lucianovk/kinova-cam/out/images/ring_d405/01_robo_completo.png

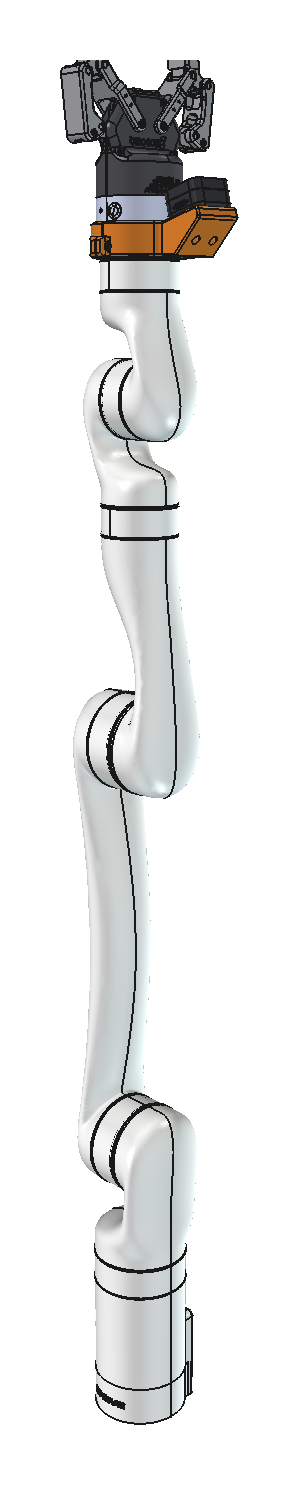
out/images/ring_d405/01_robo_completo.png
