lucianovk/kinova-cam/out/images/ring_d405/03_punho_parafusos.png

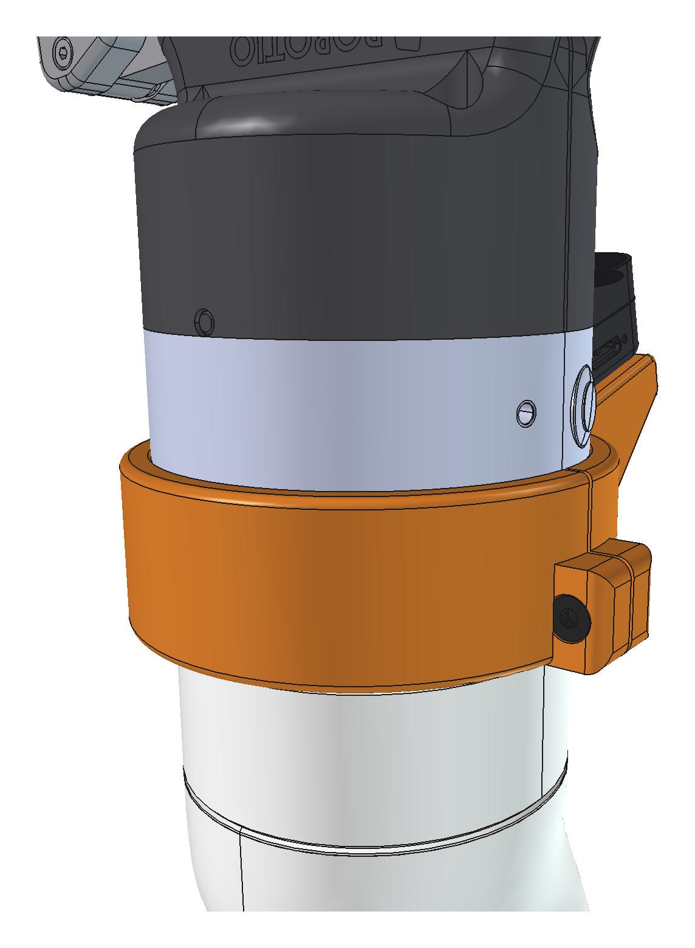
out/images/ring_d405/03_punho_parafusos.png
