lucianovk/kinova-cam/out/images/ring_d405/04_punho_lateral.png

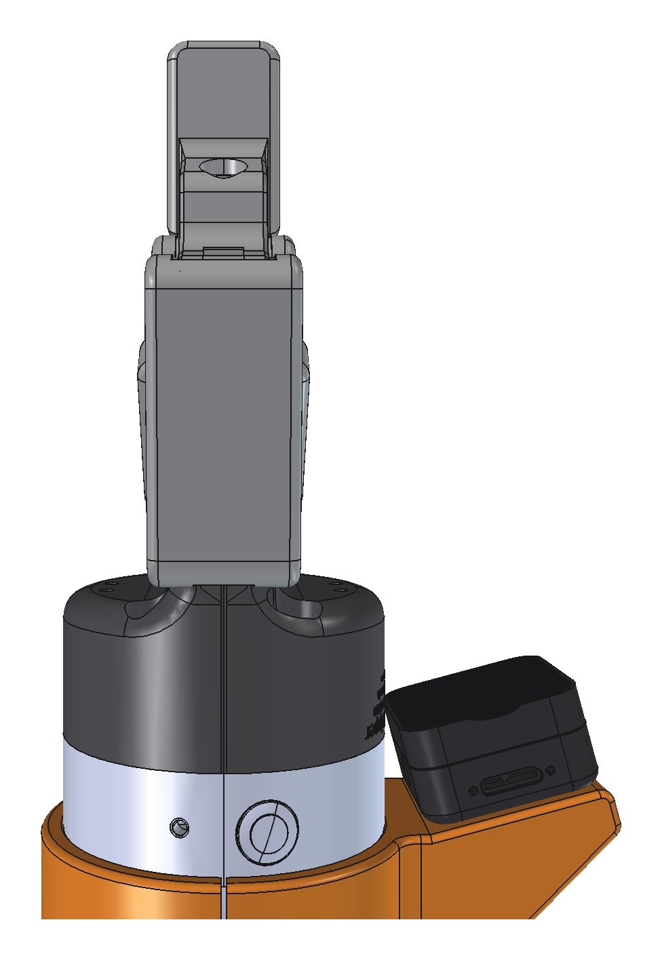
out/images/ring_d405/04_punho_lateral.png
