lucianovk/kinova-cam/out/images/ring_d405/07_explodida.png

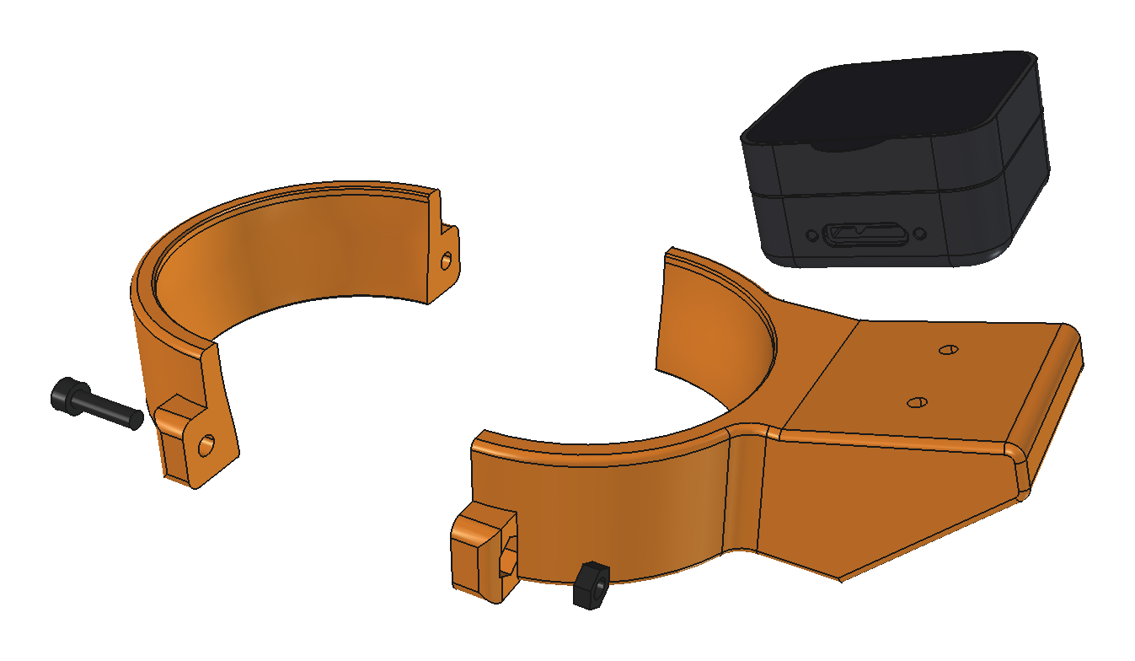
out/images/ring_d405/07_explodida.png
