lucianovk/kinova-cam/out/images/ring_d405/09_campo_de_visao.png

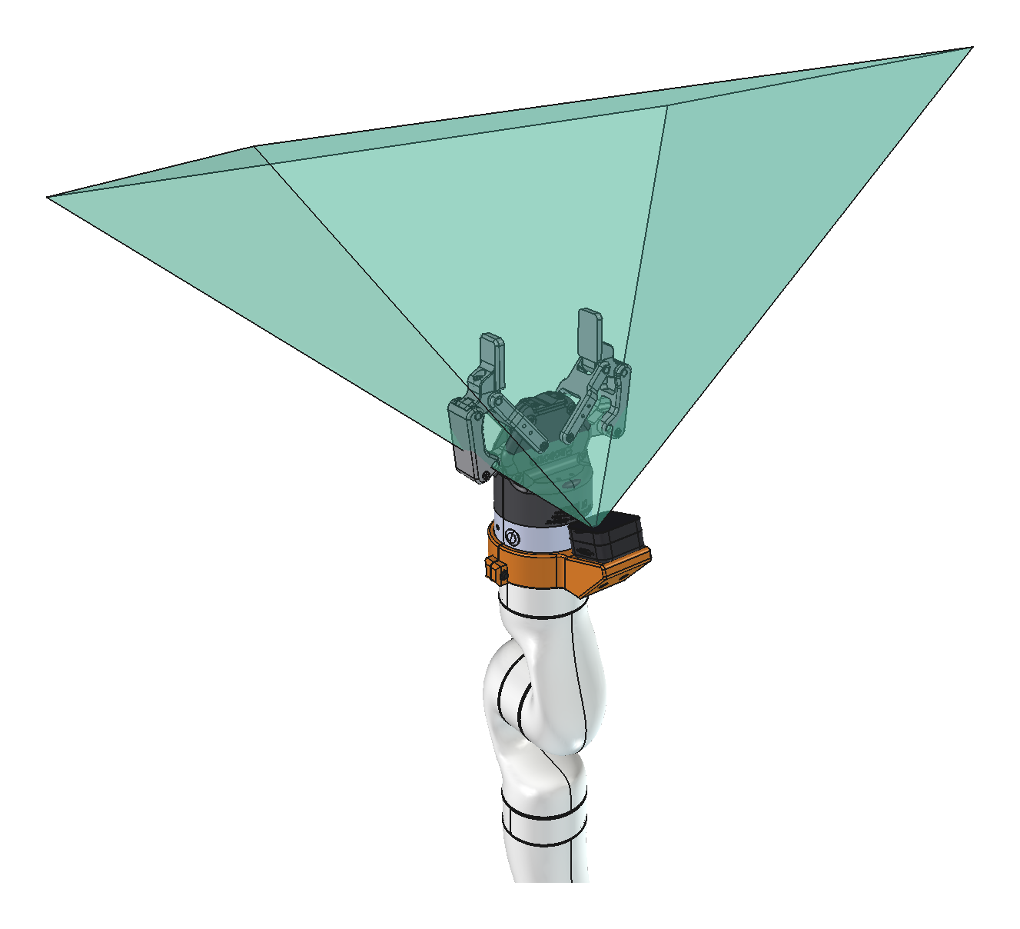
out/images/ring_d405/09_campo_de_visao.png
