lucianovk/kinova-cam/out/images/ring_rgb/01_robo_completo.png

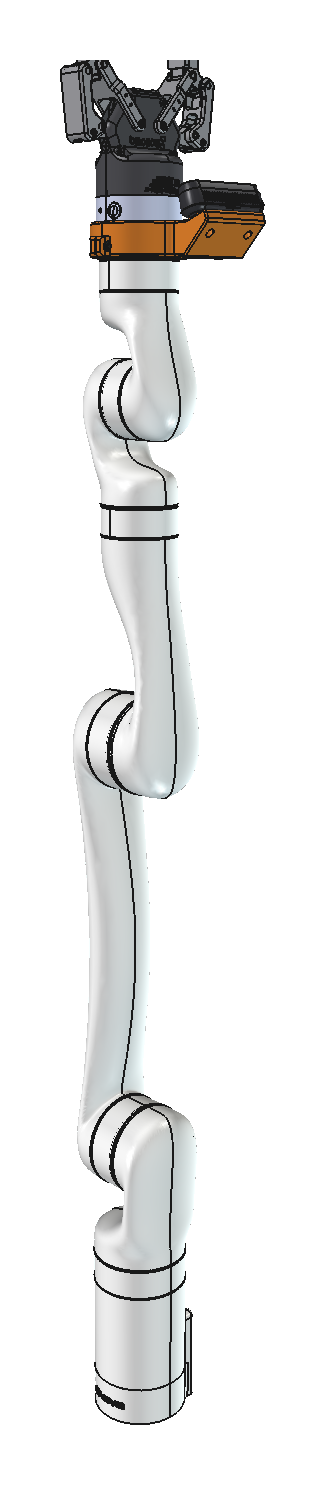
out/images/ring_rgb/01_robo_completo.png
