lucianovk/kinova-cam/out/images/ring_rgb/03_punho_parafusos.png

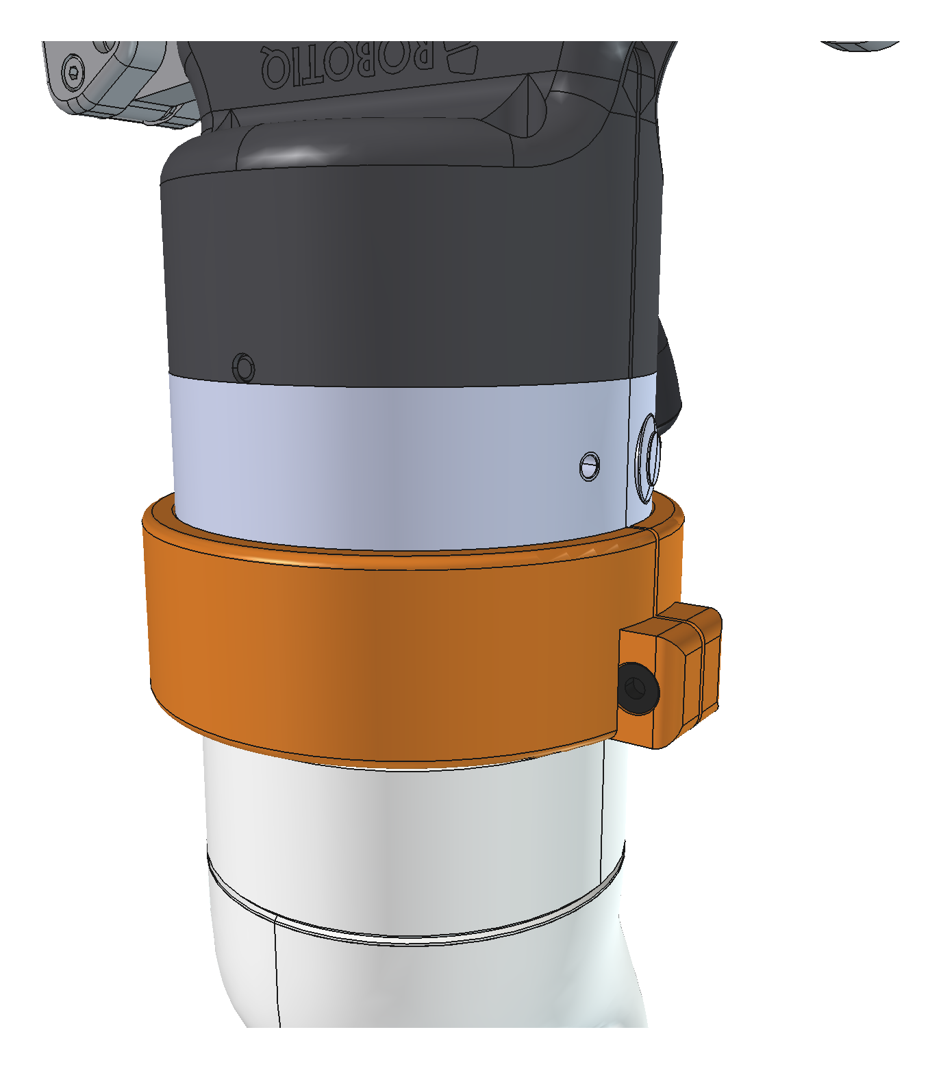
out/images/ring_rgb/03_punho_parafusos.png
