lucianovk/kinova-cam/out/images/ring_rgb/07_explodida.png

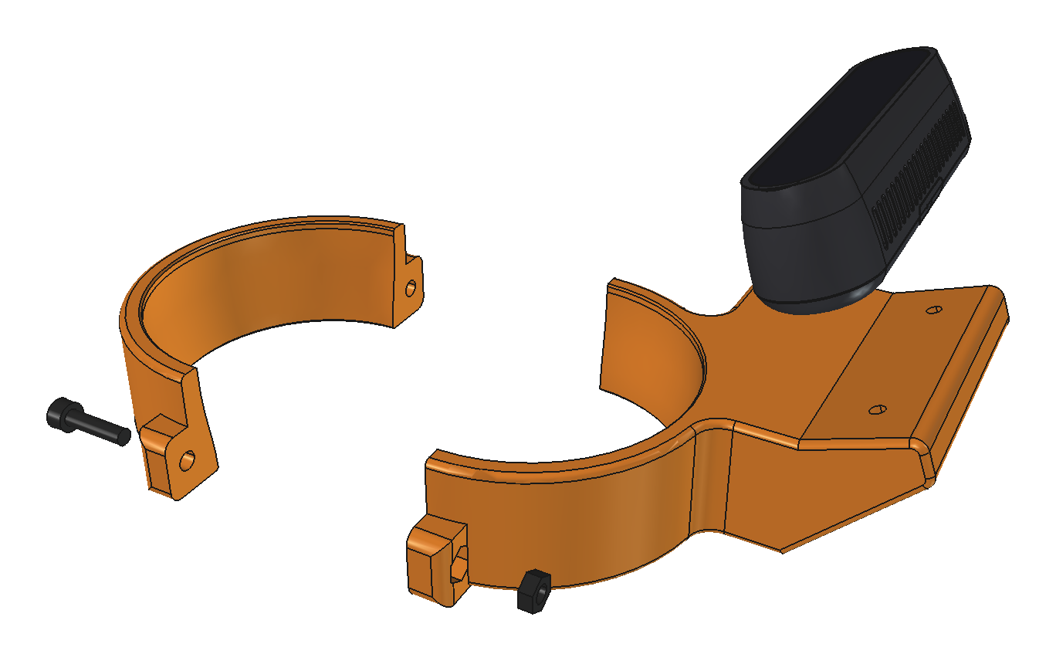
out/images/ring_rgb/07_explodida.png
