lucianovk/kinova-cam/out/images/ring_stereo/03_punho_parafusos.png

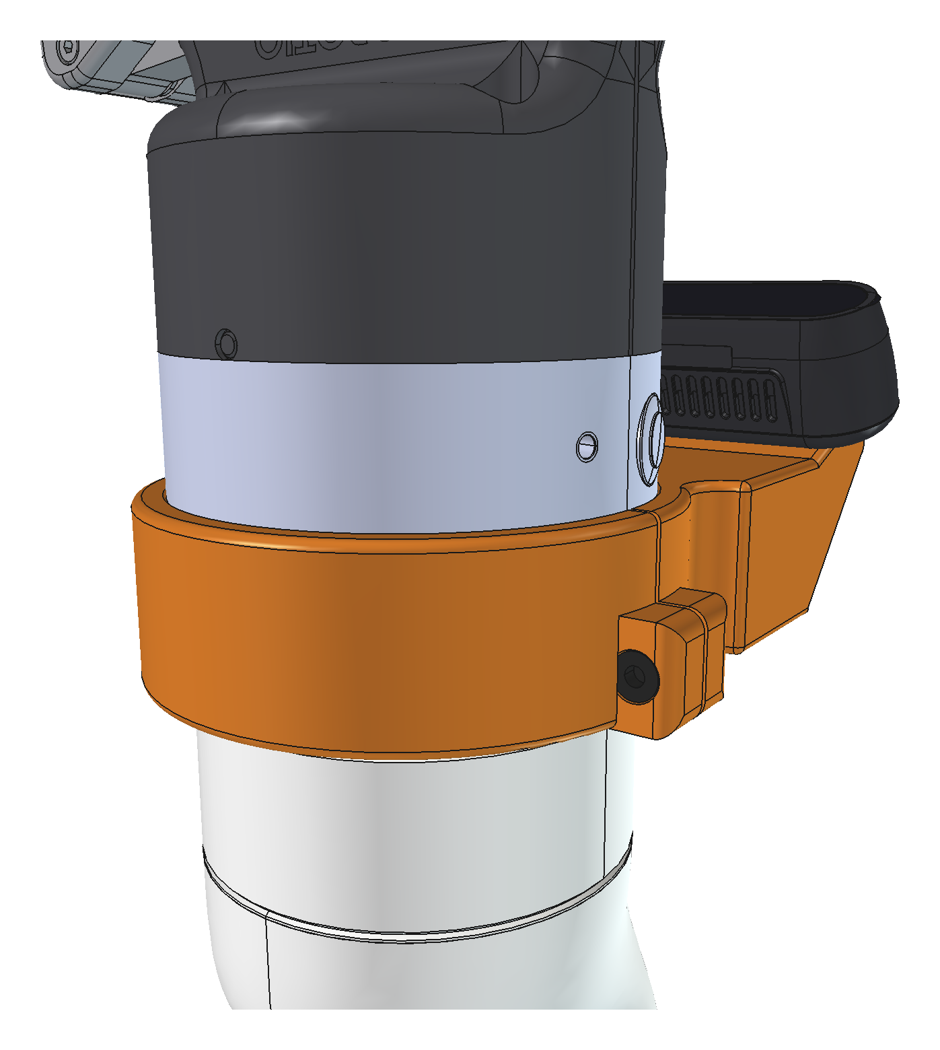
out/images/ring_stereo/03_punho_parafusos.png
