lucianovk/kinova-cam/out/images/ring_stereo/04_punho_lateral.png

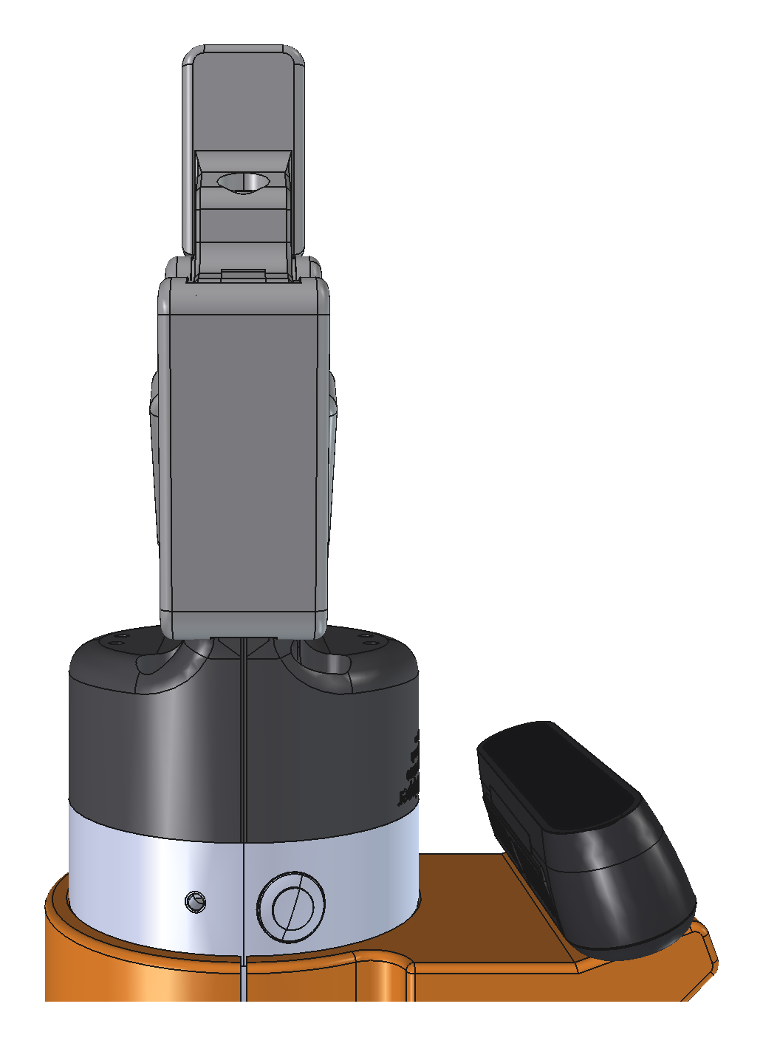
out/images/ring_stereo/04_punho_lateral.png
