lucianovk/kinova-cam/out/images/ring_stereo/06_anel_traseira.png

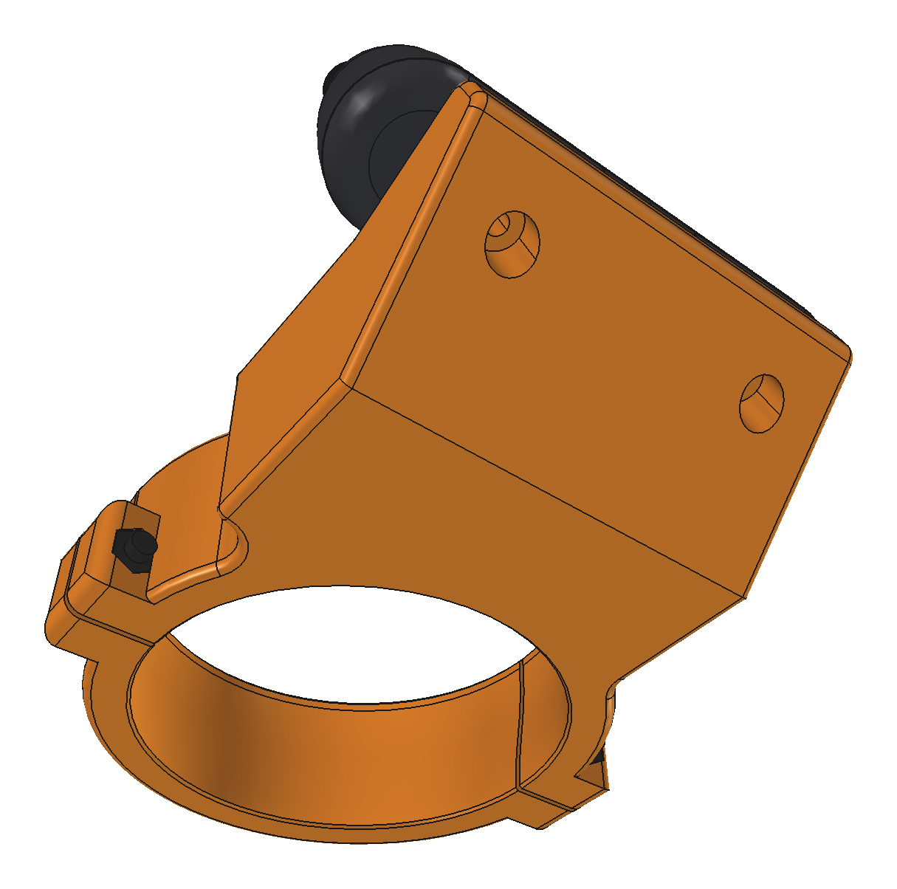
out/images/ring_stereo/06_anel_traseira.png
