lucianovk/kinova-cam/out/images/ring_stereo/07_explodida.png

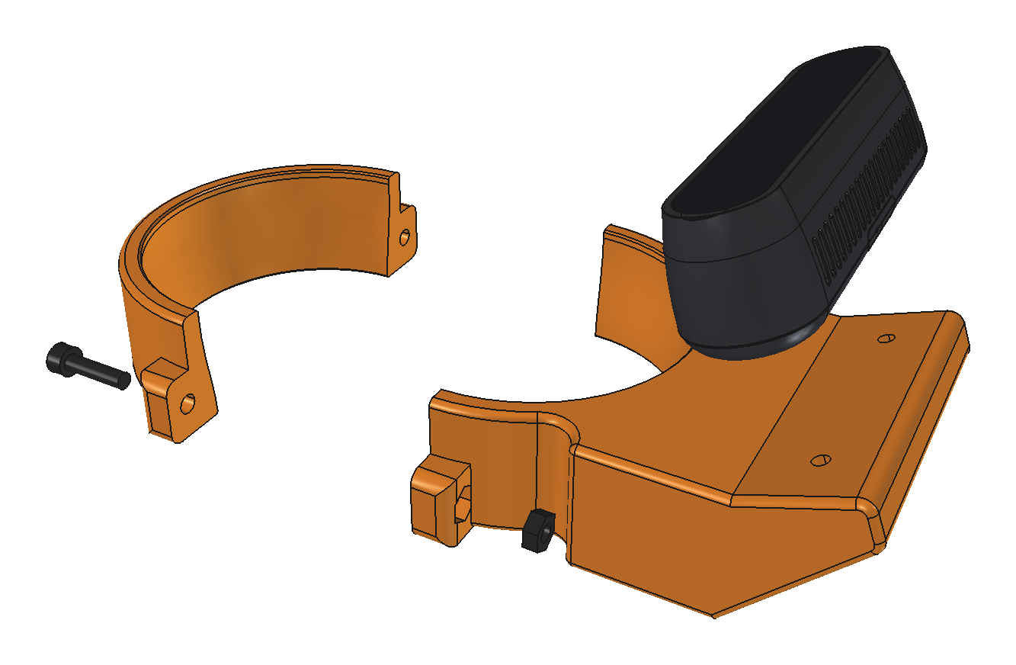
out/images/ring_stereo/07_explodida.png
