lucianovk/kinova-cam/out/ring_camera_half.step

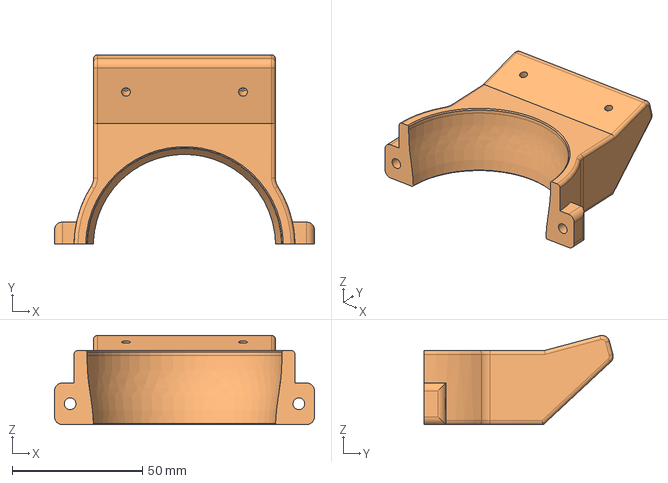
[picture p41: CAD file, 2026-10-14]
out/ring_camera_half.step
100.0 x 72.8 x 34.3 mm
