lucianovk/kinova-cam/ros/kinova_cam_description/meshes/ring_stereo_camera_half.stl

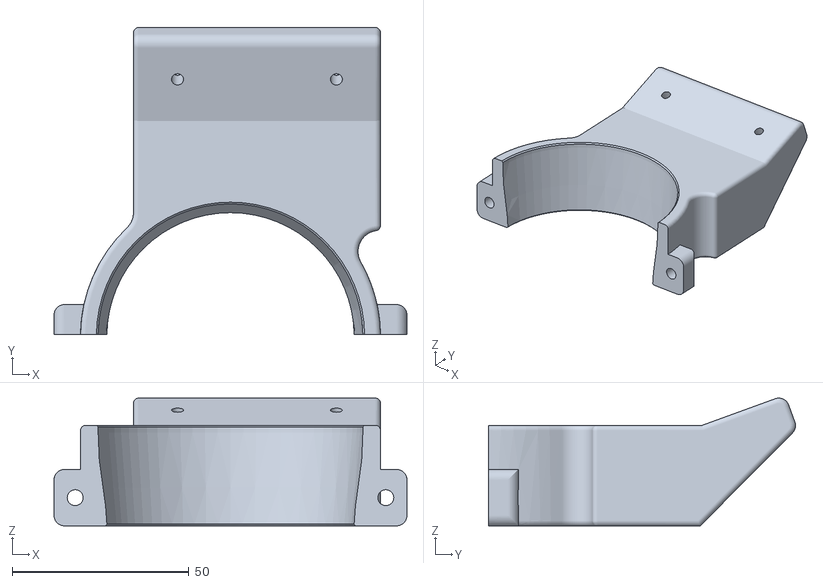
[picture p42: CAD file, 2026-10-14]
ros/kinova_cam_description/meshes/ring_stereo_camera_half.stl
100.0 x 87.0 x 36.2
