lucianovk/kinova-cam/out/ring_lower_half.step

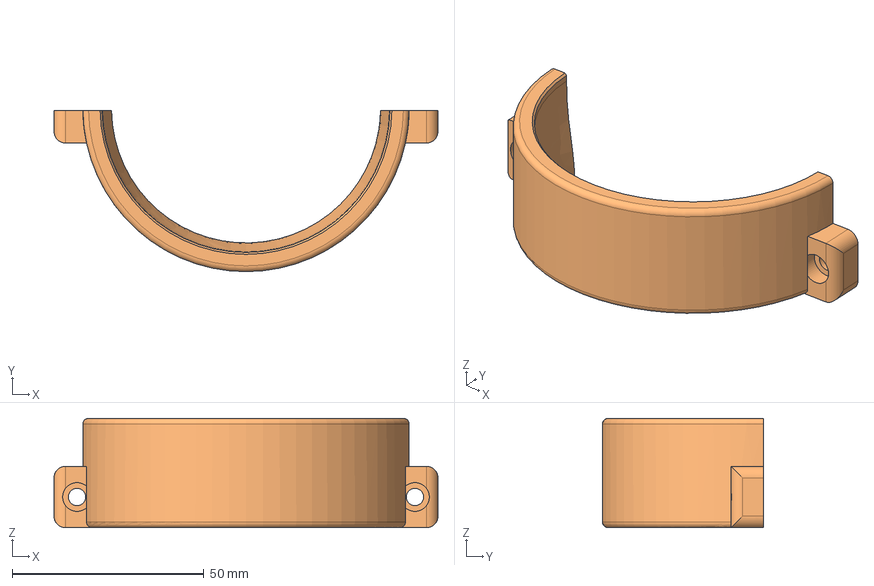
[picture p43: CAD file, 2026-10-14]
out/ring_lower_half.step
100.0 x 42.0 x 28.5 mm
