lucianovk/kinova-cam/ros/kinova_cam_description/meshes/ring_rgb_camera_half.stl

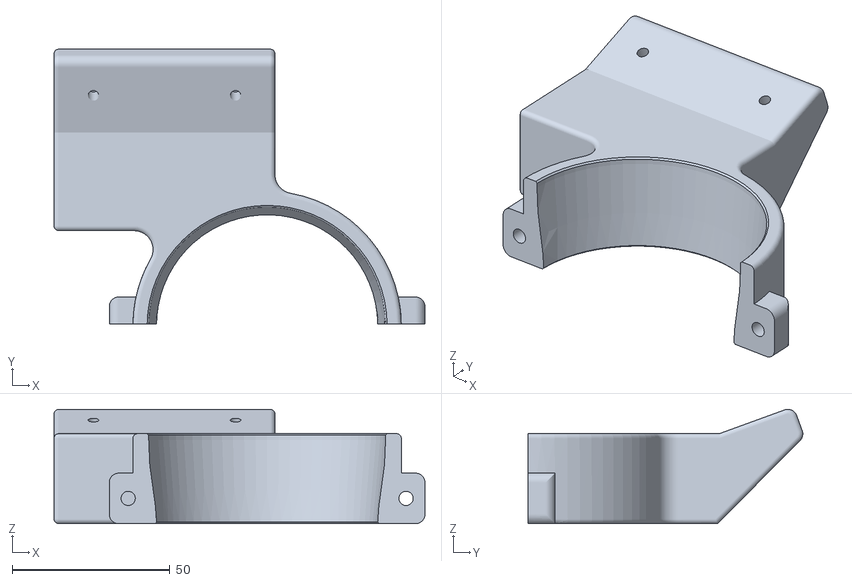
[picture p44: CAD file, 2026-10-14]
ros/kinova_cam_description/meshes/ring_rgb_camera_half.stl
117.5 x 87.0 x 36.2
