lucianovk/kinova-cam/out/ring_d405_camera_half.step

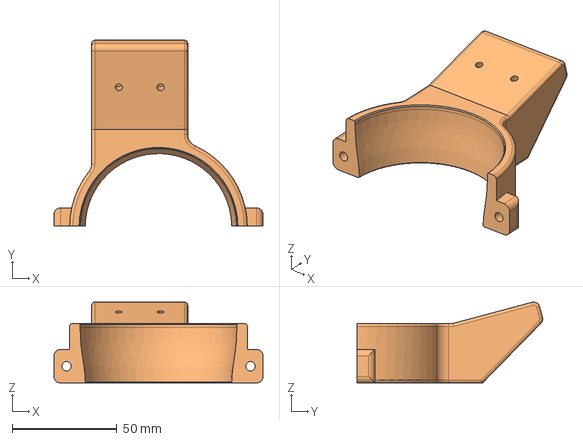
[picture p45: CAD file, 2026-10-14]
out/ring_d405_camera_half.step
100.0 x 88.8 x 38.7 mm
