lucianovk/kinova-cam/(list of files, cad)

Other CAD files:
out/ring_stereo_camera_half.step
ros/kinova_cam_description/meshes/ring_lower_half.stl
ros/kinova_cam_description/meshes/ring_d405_camera_half.stl
out/ring_rgb_camera_half.step
ros/kinova_cam_description/meshes/ring_camera_half.stl
out/ring_camera_half.stl
out/ring_d405_camera_half.stl
out/ring_lower_half.stl
out/ring_rgb_camera_half.stl
out/ring_stereo_camera_half.stl
