lucianovk/kinova-cam/(commit log)

2026-10-13 Suporte de punho para RealSense D435i no Kinova Gen3 6DOF + Robotiq 2F-85
    [adapter.step, adapter.stl, ring_camera_half.step, ring_camera_half.stl, ring_lower_half.step, ring_lower_half.stl]
2026-10-13 M3 da câmera: cabeça 3 mm mais rasa e rebaixo Ø7,5
    Os parafusos entravam demais: material sob a cabeça passa de 5 para
    8 mm (m3_screw_engage) e o rebaixo da cabeça de Ø6,5 para Ø7,5
    (m3_cbore_d). Vale para o anel e o espaçador. Ferragem passa a
    M3 × 10 (2 mm na rosca da D435i). Imagens ainda por regenerar.
    [adapter.step, adapter.stl, ring_camera_half.step, ring_camera_half.stl]
2026-10-14 Anel: câmera de pé, versões RGB/estéreo centrado e D405, pacote ROS 2
    - Remove o espaçador (adapter.py): só o anel bipartido.
    - Câmera de pé (1/4-20 voltado para o punho; garra embaixo na imagem).
    - Versões da metade da câmera, todas com a mesma metade de baixo:
    ring (original), ring_rgb (lente RGB no eixo da garra), ring_stereo
    (meio da linha de base no eixo: profundidade nas duas pontas) e
    ring_d405 (RealSense D405, CAD oficial convertido).
    - Câmeras parametrizadas (CameraSpec: D435i, D405).
    - Simulações da vista RGB e da profundidade com a garra aberta
    (camera_view.py, depth_view.py); renders por versão.
    - Pacote ROS 2 kinova_cam_description gerado do modelo (ros_exp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
    [adapter.step, adapter.stl, kinova_cam_mount.urdf.xacro, kinova_cam_mount_realsense.urdf.xacro, ring.urdf, ring_camera_half.step, ring_camera_half.stl, ring_d405.urdf]
2026-10-14 Versiona os STEP das câmeras (D435i e D405) em vendor/
    A Intel só publica o CAD em .SLDPRT; os STEP foram convertidos à mão no
    Onshape e não podem ser baixados pelo fetch_vendor.sh. O resto de
    vendor/ continua fora do git.
    Claude-Session: https://claude.ai/code/session_013duwGWXmwV8kECy4pg5jTs
